anarchyincubator/hatchtrack/3d_models/PN11SHNA03QE.stp

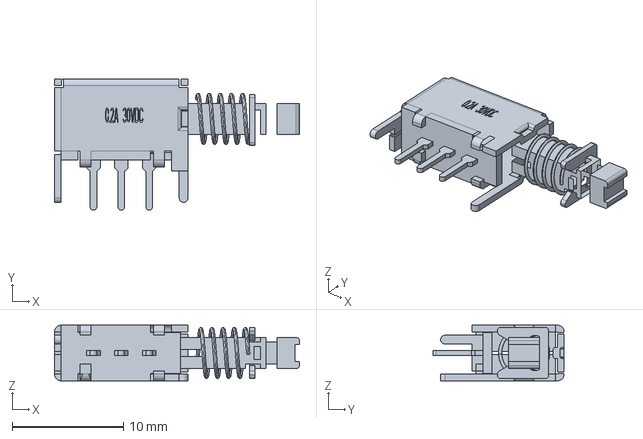
[picture p1: CAD file, 2018-10-25]
3d_models/PN11SHNA03QE.stp
22.0 x 11.8 x 5.00 mm
