anarchyincubator/hatchtrack/ht-001.step

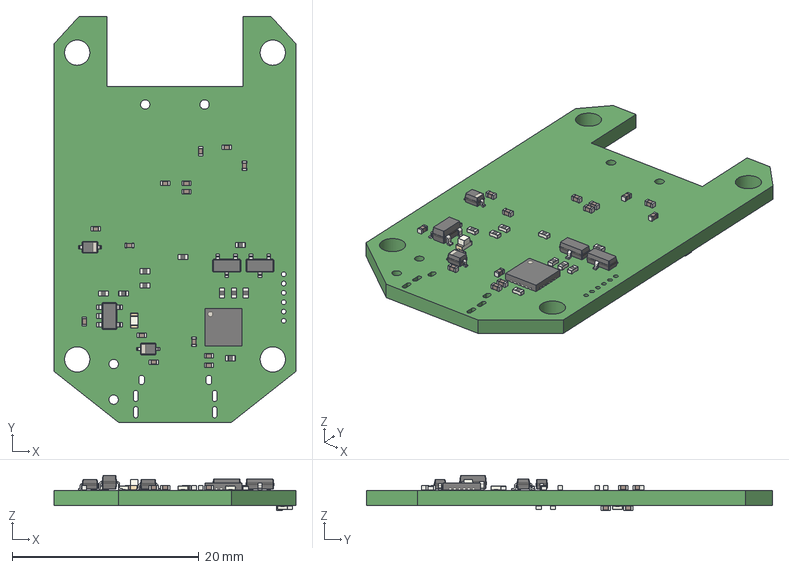
[picture p2: CAD file, 2019-05-08]
ht-001.step
25.8 x 43.5 x 3.75 mm
D_SOD-323 x 2
LED_0402
QFN-24-1EP_4x4mm_Pitch0.5mm
SOT-23-5
