anarchyincubator/hatchtrack/3d_models/C_0402_1005Metric.step

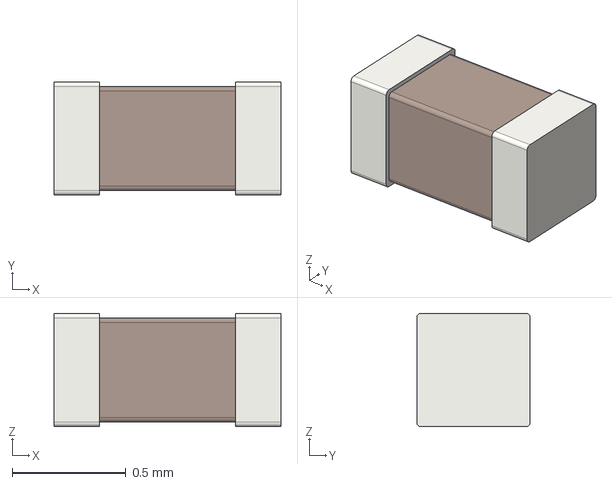
[picture p3: CAD file, 2018-10-25]
3d_models/C_0402_1005Metric.step
1.00 x 0.5 x 0.5 mm
