anarchyincubator/hatchtrack/3d_models/QFN-24-1EP_4x4mm_P0.5mm_EP2.6x2.6mm.step

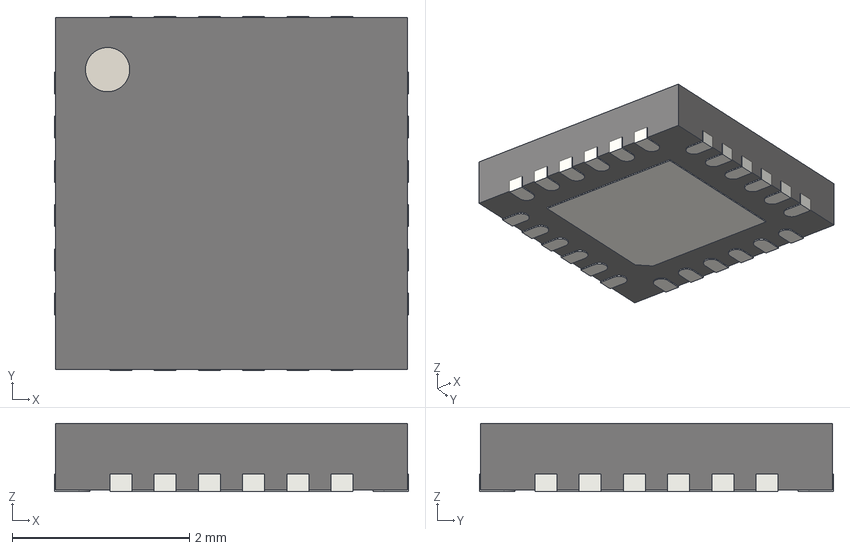
[picture p4: CAD file, 2018-10-25]
3d_models/QFN-24-1EP_4x4mm_P0.5mm_EP2.6x2.6mm.step
4.00 x 4.00 x 0.77 mm
