anarchyincubator/hatchtrack/3d_models/BME680.STEP

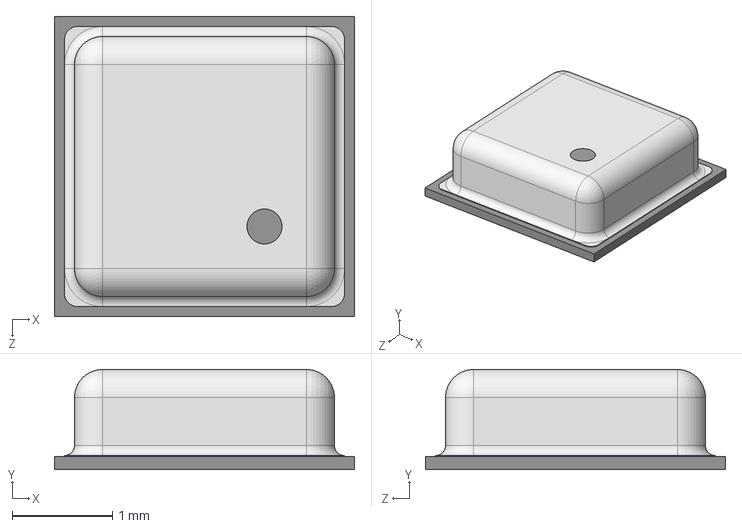
[picture p5: CAD file, 2018-10-25]
3d_models/BME680.STEP
3.00 x 1.00 x 3.00 mm
