anarchyincubator/hatchtrack/3d_models/R_0402_1005Metric.step

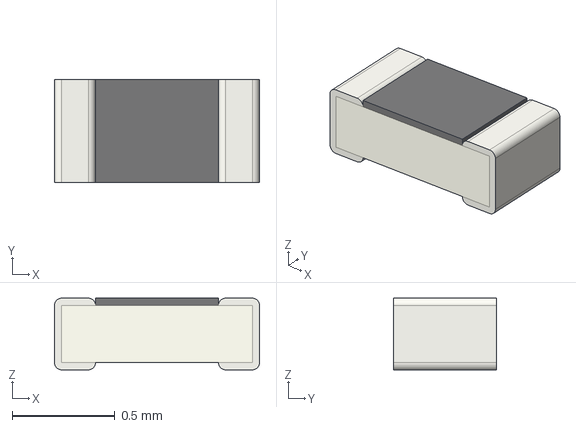
[picture p6: CAD file, 2018-10-25]
3d_models/R_0402_1005Metric.step
1.00 x 0.5 x 0.35 mm
