anarchyincubator/hatchtrack/3d_models/esp-wroom-32.step

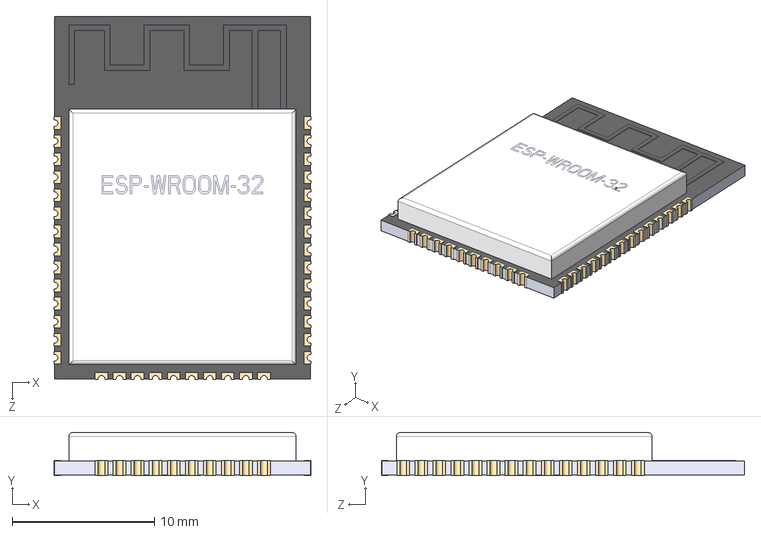
[picture p7: CAD file, 2018-10-25]
3d_models/esp-wroom-32.step
18.1 x 3.04 x 25.5 mm
