anarchyincubator/hatchtrack/ship/rev02/HATCHTRACK-02-SCH.pdf

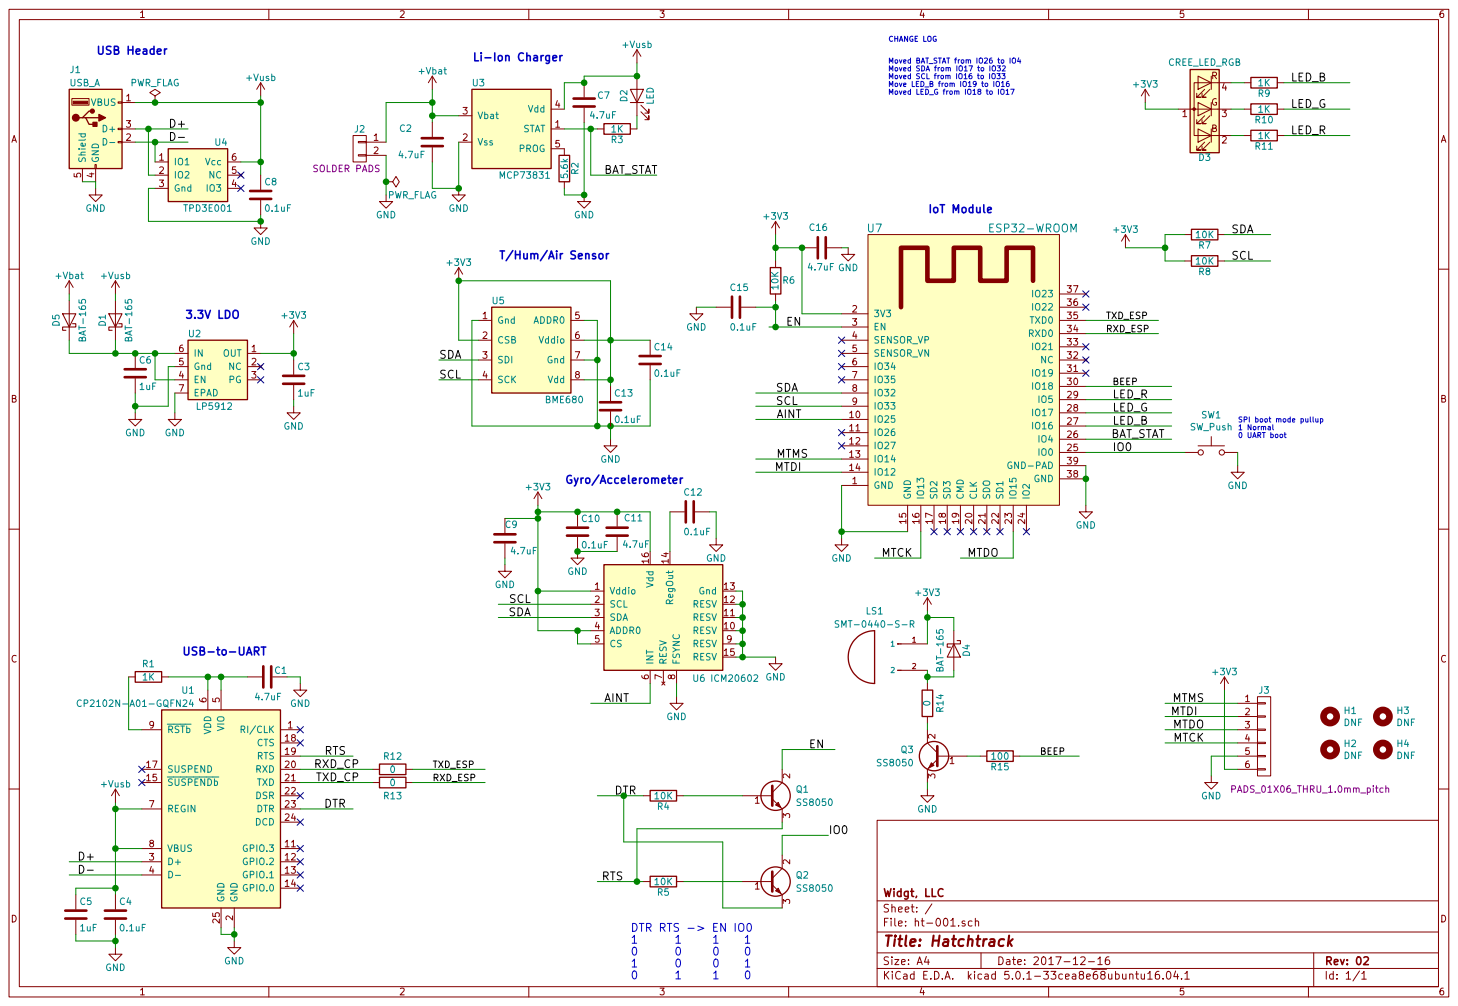
[picture p8: page 1]

Moved BAT_STAT from IO26 to IO4 Moved SDA from IO17 to IO32 Moved SCL from IO16 to IO33 Move LED_B from IO19 to IO16 Moved LED_G from IO18 to IO17 CHANGE LOG GND

6 REGIN 7 VBUS 8 RSTb 9 U1 CP2102N-A01-GQFN24 GND GND GND GND GND GND

SPI boot mode pullup

2 RXD 20 TXD 21 DSR 22 DTR 23 DCD 24 GND 25 D+ 3 D- 4 VIO

File: ht-001.sch Sheet: / Widgt, LLC
