anarchyincubator/hatchtrack/ship/rev02/HATCHTRACK-02-BOT-ASSY.pdf

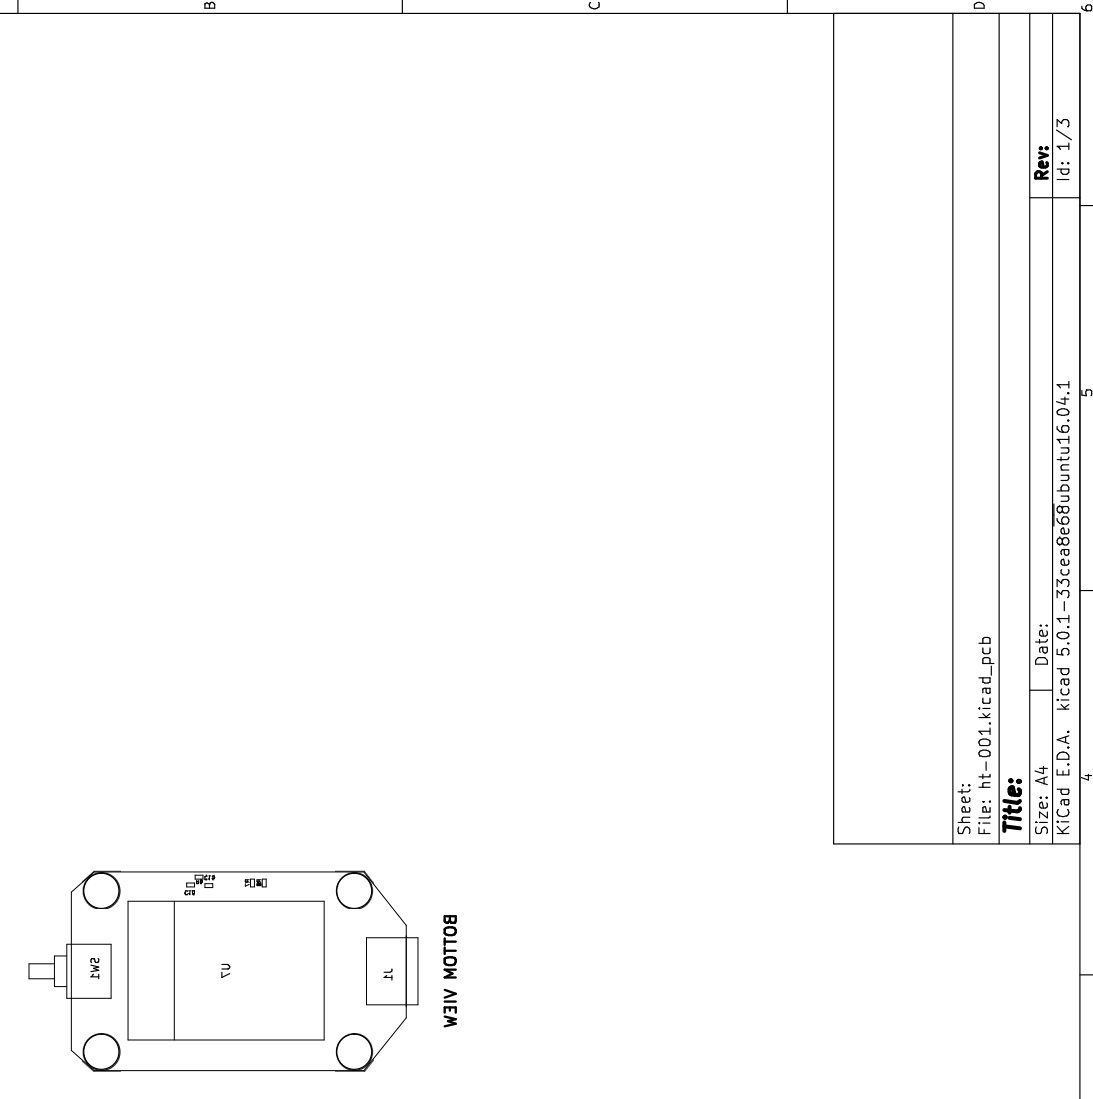
[picture p9: page 1]
