anarchyincubator/hatchtrack/ship/rev02/HATCHTRACK-02-TOP-ASSY.pdf

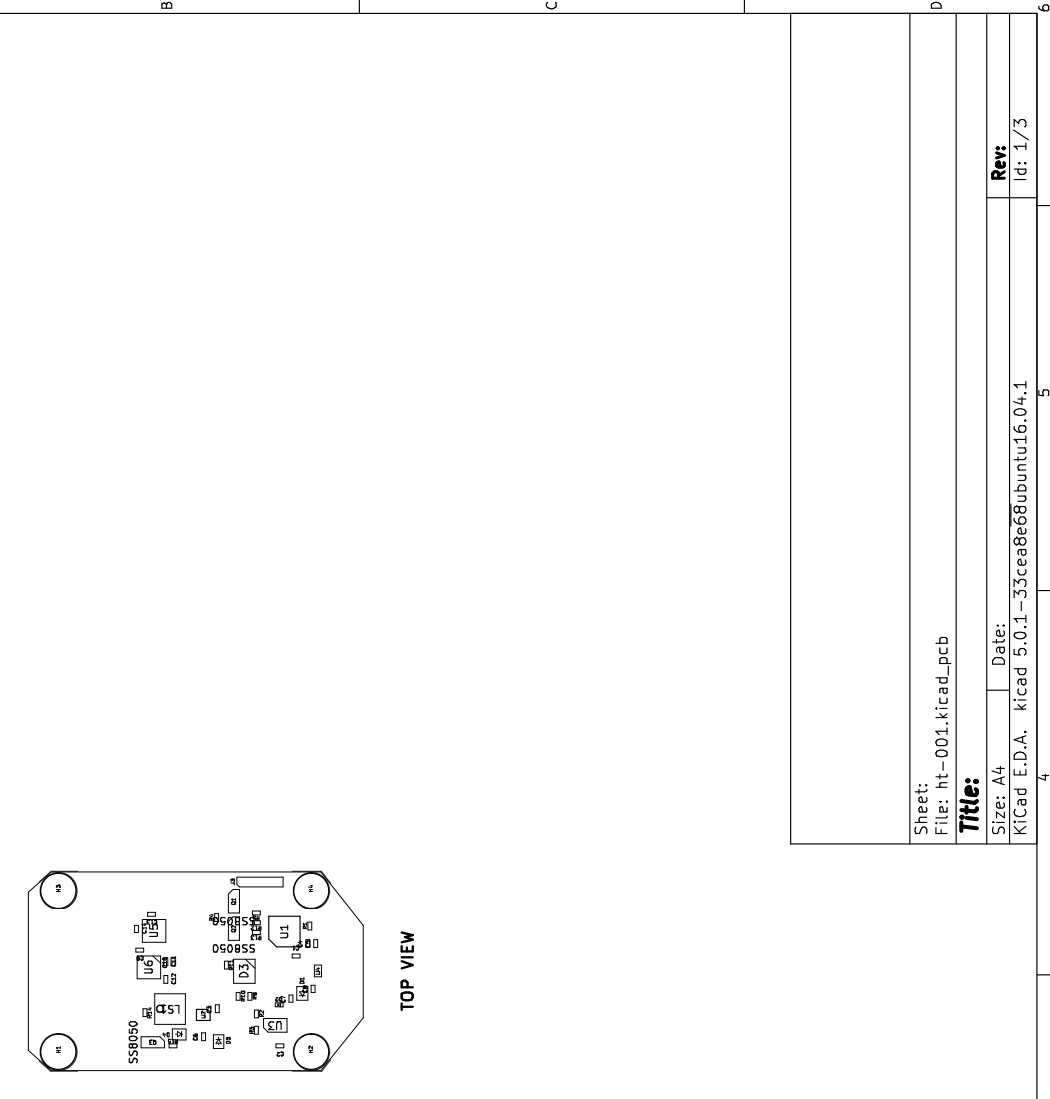
[picture p10: page 1]
