anarchyincubator/hatchtrack/(commit log)

2017-12-16 Complete with ADX343
    Debating adding all chips to schematic for pro version, and leave DNP on regular boards
    [ht-001.sch]
2017-12-16 Schematic "done"
    [ht-001.sch]
2017-12-20 switch to single IC for gyro/accel
    bit of schematic cleanup too
    [ht-001.sch]
2017-12-21 "final" schematic cleanup
    is joke
    [ht-001.kicad_pcb, ht-001.sch]
2017-12-22 schematic and layout complete?
    [ht-001.kicad_pcb, ht-001.sch]
2017-12-22 cleanup changes
    [ht-001.kicad_pcb]
2017-12-23 finished, again
    [ht-001.kicad_pcb, ht-001.sch]
2017-12-23 added thermal relief gyro/accelerometer
    [ht-001.kicad_pcb]
2017-12-25 Adding BOM
    [ht-001.csv, ht-001.kicad_pcb, ht-001.sch, ht-001_bom_.01.csv]
2018-01-08 Mostly-final layout?
    [ht-001.kicad_pcb, ht-001.sch, ht-001_bom_.01.ods]
2018-01-09 Honestly don't remember, but sent gerbers out for quotes.
    [ht-001.kicad_pcb, ht-001.sch, ht-001_bom_.01.ods]
2018-02-06 Released to prototyping
    [ht-001.csv, ht-001.kicad_pcb, ht-001.sch, ht-001_bom_.01.csv, ht-001_bom_.01.ods]
2018-07-20 updates for v2
    removed speaker, moved to 28 pin usb->uart package, switched 6 axis to icm20602, redid bootloader circuit to match dev board/ESP32 IDF
    [ht-001.kicad_pcb, ht-001.sch]
2018-09-11 schematic done, kicad 5 upgrade
    [ht-001-2018-08-14-10-30-41.sch, ht-001.kicad_pcb, ht-001.sch]
2018-10-16 the latest, and I don't remember where I left off.
    [ht-001.kicad_pcb]
2018-10-24 Started clean-up of the sch. Adding values to relevant fields. Being anal.
    [ht-001.kicad_pcb, ht-001.sch]
2018-10-25 Most of the BoM is settled. The switch is the only unknown.
    [BME680.STEP, C_0402_1005Metric.step, QFN-24-1EP_4x4mm_P0.5mm_EP2.6x2.6mm.step, R_0402_1005Metric.step, esp-wroom-32.step, ht-001.kicad_pcb, ht-001.sch]
2018-10-25 Added switch. BoM should be fairly stable
    [PN11SHNA03QE.stp, ht-001.kicad_pcb, ht-001.sch]
2018-10-27 Initial parts placement complete
    [ht-001.kicad_pcb, ht-001.sch]
2018-10-29 Project should be compartmentalized now. I think the design is ready for review. If no issues, they can be shipped to CM.
    [HATCHTRACK-02-BOM.csv, ht-001.kicad_pcb, ht-001.sch, ht-001_bom_.01.csv]
2018-10-29 Reutman found a defect in the schematic. The I2C lines were on IO34 and IO35; which are input-only. These have now been moved to IO32 and IO33; which are input-output. The following files have been r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
    [ht-001.kicad_pcb, ht-001.sch]
2018-10-30 Fixed a minor silkscreen issue
    [ht-001.kicad_pcb]
2018-10-31 Added speaker and associated circuitry. Also fixed the footprint for Q1-Q3. They were originally SOT-23-5. They needed to be SOT-23
    [ht-001.kicad_pcb, ht-001.sch]
2018-10-31 Updates for the speaker complete. New MFG files generated
    [HATCHTRACK-02-BOM.csv, ht-001.kicad_pcb, ht-001.sch]
2018-11-06 Added the diode for OR-ing VUSB and VBAT to the 3.3V regulator. Updated the layout and generated new MFG files.
    [HATCHTRACK-02-BOM.csv, ht-001.kicad_pcb, ht-001.sch]
2019-05-08 adding changes, gui seemed to stop working
    [ht-001.kicad_pcb, ht-001.sch, ht-001.step]
2019-05-08 adding new footprints
2019-05-08 adding revC bom
    [HATCHTRACK-03-BOM.csv]
