anarchyincubator/hatchtrack/(notices)

Notices in the files:
3d_models/R_0402_1005Metric.step:
Copyright (C) 2018, kicad StepUp
This work is licensed under the [Creative Commons CC-BY-SA 4.0 License](https://creativecommons.org/licenses/by-sa/4.0/legalcode),
with the following exception:
To the extent that the creation of electronic designs that use 'Licensed Material' can be considered to be 'Adapted Material',
You are free to use the library data in your own projects without the obligation to share your project files under this or any other license agreement.
3d_models/C_0402_1005Metric.step:
Copyright (C) 2017, kicad StepUp
3d_models/QFN-24-1EP_4x4mm_P0.5mm_EP2.6x2.6mm.step:
This program is free software: you can redistribute it and/or modify
it under the terms of the GNU General Public License as published by
the Free Software Foundation, either version 3 of the License, or
any later version.
itself might be covered by the GNU General Public License.
